murgui/AudioAmpli/Reference Documents/My_Ref FE - BOM (From v1.5 boards).xlsx

Sheet: BOM
My_Ref Fremen Edition BOM (v1.5 and up)
Position |  |  |  |  |  | Suggested Best Part |  | Mouser |  | Parts Connexion | Notes | Mouser Import Tool
Part |  | Value | Rating | Package | Q.ty | Manifacturer | Part | Order # | Notes | Order # |  | BOM (FE) | BOM (FE+Evo A Mod) | BOM w/o SMD (FE) | BOM w/o SMD (FE+Evo A Mod)
Amplifier
C1, C2 |  | 470uf | 50V | E7,5-16 | 2 | Nichicon | PW | 647-UPW1H471MHD |  |  |  | 647-UPW1H471MHD|2 | 647-UPW1H471MHD|2 | 647-UPW1H471MHD|2 | 647-UPW1H471MHD|2
C4 |  | 100nf | 250V | C10B5 | 1 | Wima | MKP4 | 505-MKP4.1/250/10P |  |  |  | 505-MKP4.1/250/10P|1 | 505-MKP4.1/250/10P|1 | 505-MKP4.1/250/10P|1 | 505-MKP4.1/250/10P|1
C7 |  | 10nf | 50V | C5B6.5 | 1 | Wima | FKP2 | 505-FKP20.01/100/2.5 |  |  |  | 505-FKP20.01/100/2.5|1 | 505-FKP20.01/100/2.5|1 | 505-FKP20.01/100/2.5|1 | 505-FKP20.01/100/2.5|1
C9 |  | 220uF | 50V | E7,5-16 | 1 | Elna | Cerafine (*) | 647-UKZ1H221MH | Nichicon KZ | BLKGATE-60166 | Blackgate STD and PK are best, if you can find them at decent price, The 4V PK from PCX are cheap and will work perfectly, buy them until they're available. Mouser alternate: 647-UFG1J221MHM | 647-UKZ1H221MH|1 | 647-UKZ1H221MH|1 | 647-UKZ1H221MH|1 | 647-UKZ1H221MH|1
C10 | (FE) | 33pF |  | C5B3.5 | 1 | CDE | CD10 | 598-CD10ED330JO3F |  |  |  | 598-CD10ED330JO3F|1 |  | 598-CD10ED330JO3F|1
 | (Evo Rev. A Mod) | Leave unpopulated
C12 |  | 220pf | 100V 2.5% | C5B4.5 | 1 | Amtrans | AMCH (**) | 505-FKP2220/100/2.5 | Wima FKP2 | AMTRANS-73778 |  | 505-FKP2220/100/2.5|1 | 505-FKP2220/100/2.5|1 | 505-FKP2220/100/2.5|1 | 505-FKP2220/100/2.5|1
C13 |  | 1uF | 250V | 24*38 | 1 | Mundorf | MCAP Supreme (***) | 598-940C6W1K-F | CDE 940C | MUNDORF-70326 |  | 598-940C6W1K-F|1 | 598-940C6W1K-F|1 | 598-940C6W1K-F|1 | 598-940C6W1K-F|1
C30 |  | 1nf | 100V | C5B4.5 | 1 | Amtrans | AMCH (**) | 505-FKP21000/100/2.5 | Wima FKP2 | AMTRANS-73784 |  | 505-FKP21000/100/2.5|1 | 505-FKP21000/100/2.5|1 | 505-FKP21000/100/2.5|1 | 505-FKP21000/100/2.5|1
C32 |  | 150pf | 100V 2.5% | C5B4.5 | 1 | Amtrans | AMCH (**) | 505-FKP2150/100/2.5 | Wima FKP2 | AMTRANS-73852 |  | 505-FKP2150/100/2.5|1 | 505-FKP2150/100/2.5|1 | 505-FKP2150/100/2.5|1 | 505-FKP2150/100/2.5|1
C34 |  | 27pf | 50V | C0805 | 1 | CDE | MC | 5982-08-100V27-F |  |  |  | 5982-08-100V27-F|1 | 5982-08-100V27-F|1
 | (FE Economy) |  |  |  | 1 | Vishay Vitramon | VJ Commercial (C0G) | 77-VJ0805A270JXBMC
D1, D2 |  | BAV99 |  | SOT23 | 2 | NXP | BAV-99 | 771-BAV99/8215 |  |  |  | 771-BAV99/8215|2 | 771-BAV99/8215|2
D3 |  | 27V | 1/2W | SOD80C | 1 | NXP | BZV55 | 771-BZV55-C27115 |  |  |  | 771-BZV55-C27115|1 | 771-BZV55-C27115|1
IC1 |  | LM318M |  | SO8 | 1 | NatSemi | LM318M | 926-LM318M/NOPB |  |  |  | 926-LM318M/NOPB|1 | 926-LM318M/NOPB|1
IC2 |  | LM3886TF |  | TO220-11 | 1 | NatSemi | LM3886TF | 926-LM3886TF/NOPB |  |  |  | 926-LM3886TF/NOPB|1 | 926-LM3886TF/NOPB|1 | 926-LM3886TF/NOPB|1 | 926-LM3886TF/NOPB|1
R2 |  | 10K | 1/4W 2% | R1206 | 1 | Vishay | CMA0204 | 594-CMA02040X1002GB3 |  |  |  | 594-CMA02040X1002GB3|1 | 594-CMA02040X1002GB3|1
R3 | (FE) | 0R47 | 5W | TO220 | 1 | Caddock | MP-930 | 684-MP930-0.5 |  |  |  | 684-MP930-0.5|1 |  | 684-MP930-0.5|1
 | (FE Economy) |  |  |  | 1 | Ohmite | TWW | 588-TWW5JR47E |  |  | No heaksing needed!
 | (Evo Rev. A Mod) | 0R33 | 5W | TO220 | 1 | Caddock | MP-930 | 684-MP930-0.33 |  |  |  |  | 684-MP930-0.33|1 |  | 684-MP930-0.33|1
R3 Heatsink |  |  |  | TO220 | 1 | Aavid Thermalloy |  | 532-577102B00 |  |  |  | 532-577102B00|1 | 532-577102B00|1 | 532-577102B00|1 | 532-577102B00|1
R5, R8 |  | 22K | 1/4W 0.1% | R1206 | 2 | Susumu | RG32 | 754-RG3216P-2202-BT5 |  |  |  | 754-RG3216P-2202-BT5|2 | 754-RG3216P-2202-BT5|2
R6, R9 |  | 47K | 1/4W 0.1% | R1206 | 2 | Susumu | RG32 | 754-RG3216P-4702-BT5 |  |  |  | 754-RG3216P-4702-BT5|2 | 754-RG3216P-4702-BT5|2
R7 |  | 12K | 1/4W 1% | B/R1206 | 1 | Susumu | RG32 (****) | 754-RG3216P-1202-BT5 |  | VISHAY-80834 |  | 754-RG3216P-1202-BT5|1 | 754-RG3216P-1202-BT5|1
R10 |  | 390R | 1/4W 1% | B/0207 | 1 | Vishay Dale | RN55 (****) | 71-RN55C3920B/R |  | VISHAY-74659 |  | 71-RN55C3920B/R|1 | 71-RN55C3920B/R|1 | 71-RN55C3920B/R|1 | 71-RN55C3920B/R|1
R11 |  | 1R | 1/4W 1% | 0207 | 1 | Vishay Dale | RN55 | 71-RN55D-F-1 |  |  |  | 71-RN55D-F-1|1 | 71-RN55D-F-1|1 | 71-RN55D-F-1|1 | 71-RN55D-F-1|1
R12 |  | 3K3 | 1/4W 1% | B/0207 | 1 | Vishay Dale | RN55 (****) | 71-RN55E3321B |  | VISHAY-73805 |  | 71-RN55E3321B|1 | 71-RN55E3321B|1 | 71-RN55E3321B|1 | 71-RN55E3321B|1
 | V1.5 Only |  |  |  | 1 | Susumu | RG32 | 754-RG3216P-3301DT5 |  | VISHAY-73805
R37 |  | 3K3 | 1/4W 1% | R1206 | 1 | Susumu | RG32 | 754-RG3216P-3301DT5 |  | VISHAY-73805 |  | 754-RG3216P-3301DT5|1 | 754-RG3216P-3301DT5|1
R13 |  | 100K | 1/4W 1% | B/0207 | 1 | Vishay Dale | RN55 (****) | 71-RN55E-B-100K |  | VISHAY-73811 |  | 71-RN55E-B-100K|1 | 71-RN55E-B-100K|1 | 71-RN55E-B-100K|1 | 71-RN55E-B-100K|1
R39 | (FE) | 470K | 1/4W 1% | R0805 | 1 | Susumu | RG20 | 754-RG2012P-474-BT5 |  |  |  | 754-RG2012P-474-BT5|1
 | (Evo Rev. A Mod) | Leave unpopulated
R43 |  | 22K | 1/4W 1% | R0805 | 1 | Susumu | RG20 | 754-RG2012P-223-B-T5 |  |  | Alt. 754-RS2012P-223-DT53 | 754-RG2012P-223-B-T5 |1 | 754-RG2012P-223-B-T5 |1
Power Supply
C101, C201 |  | 10,000uf | 50V | EB35D | 2 | Mundorf | M-Lythic AG | 594-MAL225658103E3 | 256 PMG-SI | MUNDORF-74876 | Alternate: 647-LKG1H103MESCBK | 594-MAL225658103E3|2 | 594-MAL225658103E3|2 | 594-MAL225658103E3|2 | 594-MAL225658103E3|2
C103, C203 | (Optional) | 100nF | 100V C0G | C1206 | 2 | TDK | C Series | 810-C3216C0G2A104J6C |  |  | Not needed
D105, D205 |  | 14V | 1/2W | DO35 | 2 | Fairchild | 1N5244B | 512-1N5244B |  |  |  | 512-1N5244B|2 | 512-1N5244B|2 | 512-1N5244B|2 | 512-1N5244B|2
D101-D104, D201-D204 |  | MUR820 |  | TO220 | 8 | OnSemi | MUR820G | 863-MUR820G |  |  |  | 863-MUR820G|8 | 863-MUR820G|8 | 863-MUR820G|8 | 863-MUR820G|8
IC101, IC201 |  | LM317 |  | TO220 | 2 | OnSemi | LM317TG | 863-LM317TG |  |  |  | 863-LM317TG|2 | 863-LM317TG|2 | 863-LM317TG|2 | 863-LM317TG|2
IC101, IC201 Heatsink |  |  |  | TO220 | 2 | Aavid Thermalloy | 577102B00000G | 532-577102B00 |  |  | Alternate: 532-577002B00 | 532-577102B00|2 | 532-577102B00|2 | 532-577102B00|2 | 532-577102B00|2
TO 220 Mounting kit |  |  |  |  | 2 | Aavid Thermalloy | 4880MG | 532-4880M |  |  |  | 532-4880M|2 | 532-4880M|2 | 532-4880M|2 | 532-4880M|2
R101, R201 |  | 50R | 1/2W 1% | B/0207 | 2 | Vishay Dale | RN55 | 71-RN55C-B-50 |  |  |  | 71-RN55C-B-50|2 | 71-RN55C-B-50|2 | 71-RN55C-B-50|2 | 71-RN55C-B-50|2
R104, R204 |  | 200R | 1/2W 1% | B/0207 | 2 | Vishay Dale | RN55 | 71-RN55C-B-200/R |  |  |  | 71-RN55C-B-200/R|2 | 71-RN55C-B-200/R|2 | 71-RN55C-B-200/R|2 | 71-RN55C-B-200/R|2
T101 |  | BD139-16 | 1W | TO126 | 1 | Fairchild | BD139-16 | 512-BD13916S |  |  |  | 512-BD13916S|1 | 512-BD13916S|1 | 512-BD13916S|1 | 512-BD13916S|1
T201 |  | BD140-16 | 1W | TO126 | 1 | Fairchild | BD140-16 | 512-BD14016S |  |  |  | 512-BD14016S|1 | 512-BD14016S|1 | 512-BD14016S|1 | 512-BD14016S|1
DC & Speaker Protection
C14 |  | 220uf | 50V | E5-10.5 | 1 | Panasonic | FM | 667-EEU-FM1H221 |  |  |  | 667-EEU-FM1H221|1 | 667-EEU-FM1H221|1 | 667-EEU-FM1H221|1 | 667-EEU-FM1H221|1
C15 |  | 22uf | 25V | E2,5-5 | 1 | Nichicon | FG | 647-UFG1E220MDM |  |  |  | 647-UFG1E220MDM|1 | 647-UFG1E220MDM|1 | 647-UFG1E220MDM|1 | 647-UFG1E220MDM|1
C16 |  | 100uf | 25V | E3.5-8 | 1 | Nichicon | FG | 647-UFG1E101MPM |  |  |  | 647-UFG1E101MPM|1 | 647-UFG1E101MPM|1 | 647-UFG1E101MPM|1 | 647-UFG1E101MPM|1
D4 |  | 1N4001 |  | D-7.5 | 1 | Any | 1N4001 | 625-1N4001-E3/54 |  |  |  | 625-1N4001-E3/54|1 | 625-1N4001-E3/54|1 | 625-1N4001-E3/54|1 | 625-1N4001-E3/54|1
DR1, DR2 |  | SBYV27 | 100V | D-10 | 2 | Vishay | SBYV27-100 | 625-SBYV27-100-E3 |  |  |  | 625-SBYV27-100-E3|2 | 625-SBYV27-100-E3|2 | 625-SBYV27-100-E3|2 | 625-SBYV27-100-E3|2
LED |  | Red |  | 3mm | 1 | Any |  | 78-TLHR4900 |  |  |  | 78-TLHR4900|1 | 78-TLHR4900|1 | 78-TLHR4900|1 | 78-TLHR4900|1
R14 |  | 470R | 2W | 0409 | 1 | Any |  | MOS1CT52R471J | KOA MF |  |  | MOS1CT52R471J|1 | MOS1CT52R471J|1 | MOS1CT52R471J|1 | MOS1CT52R471J|1
R15, R16 |  | 75K | 1/4W | 0207 | 2 | Any |  | 660-MF1/4CC7502F | KOA MF |  |  | 660-MF1/4CC7502F|2 | 660-MF1/4CC7502F|2 | 660-MF1/4CC7502F|2 | 660-MF1/4CC7502F|2
R19 |  | 10K | 1/4W | 0207 | 1 | Any |  | 660-MF1/4CC1002F | KOA MF |  |  | 660-MF1/4CC1002F|1 | 660-MF1/4CC1002F|1 | 660-MF1/4CC1002F|1 | 660-MF1/4CC1002F|1
R20 |  | 47K | 1/4W | 0207 | 1 | Any |  | 660-MF1/4CC4702F | KOA MF |  |  | 660-MF1/4CC4702F|1 | 660-MF1/4CC4702F|1 | 660-MF1/4CC4702F|1 | 660-MF1/4CC4702F|1
R21 |  | 220K | 1/4W | 0207 | 1 | Any |  | 660-MF1/4CC2213F | KOA MF |  |  | 660-MF1/4CC2213F|1 | 660-MF1/4CC2213F|1 | 660-MF1/4CC2213F|1 | 660-MF1/4CC2213F|1
R22 |  | 8K2 | 1/4W | 0207 | 1 | Any |  | 660-MF1/4DCT52R8201F | KOA MF |  |  | 660-MF1/4DCT52R8201F|1 | 660-MF1/4DCT52R8201F|1 | 660-MF1/4DCT52R8201F|1 | 660-MF1/4DCT52R8201F|1
R23 |  | 6K8 | 1W | 0207 | 1 | Any |  | MF1/2DC6811F | KOA MF |  |  | MF1/2DC6811F|1 | MF1/2DC6811F|1 | MF1/2DC6811F|1 | MF1/2DC6811F|1
K1 |  | G5LE | DC24V |  | 1 | Omron | G5LE-14-DC24 | 653-G5LE-14-DC24 |  |  | Alternate: 653-G5LE-1-DC24 | 653-G5LE-14-DC24|1 | 653-G5LE-14-DC24|1 | 653-G5LE-14-DC24|1 | 653-G5LE-14-DC24|1
Q1 |  | BC639 |  | TO-92 | 1 | Any |  | 512-BC63916D74Z | Fairchild |  |  | 512-BC63916D74Z|1 | 512-BC63916D74Z|1 | 512-BC63916D74Z|1 | 512-BC63916D74Z|1
Q2, Q3 |  | BC546A |  | TO-92 | 2 | Any |  | 512-BC546CTA | Fairchild |  |  | 512-BC546CTA|2 | 512-BC546CTA|2 | 512-BC546CTA|2 | 512-BC546CTA|2
Connectors & Hardware
AC1, AC2, NAC1, NAC2,OUT, OUT_GND, PWR_GND | PCB Faston |  |  |  | 7 | Keystone / Tyco | 1287 | 534-1287 |  |  |  | 534-1287|7 | 534-1287|7 | 534-1287|7 | 534-1287|7
AC1, AC2, NAC1, NAC2,OUT, OUT_GND, PWR_GND | Faston | Brass |  |  | 7 | TE |  | 571-612271 |  |  |  | 571-612271|7 | 571-612271|7 | 571-612271|7 | 571-612271|7
IN (Pin steap header) |  | Gold plated |  |  | 1 | Molex | 22-11-2022 | 538-22-11-2022 |  |  |  | 538-22-11-2022|1 | 538-22-11-2022|1 | 538-22-11-2022|1 | 538-22-11-2022|1
EXT_LED (Pin steap header) |  | Tinned |  |  | 1 | Molex | 22-23-2021 | 538-22-23-2021 |  |  |  | 538-22-23-2021|1 | 538-22-23-2021|1 | 538-22-23-2021|1 | 538-22-23-2021|1
Molex crimp pin |  | Gold plated |  |  | 6 | Molex | 08-65-0816 | 538-08-65-0816 |  |  |  | 538-08-65-0816|6 | 538-08-65-0816|6 | 538-08-65-0816|6 | 538-08-65-0816|6
Molex crimp housing |  |  |  |  | 2 | Molex | 10-11-2023 | 538-10-11-2023 |  |  |  | 538-10-11-2023|2 | 538-10-11-2023|2 | 538-10-11-2023|2 | 538-10-11-2023|2
Spacer |  | M3 |  |  | 4 | Harwin | R30-1001002 | 855-R30-1001002 |  |  |  | 855-R30-1001002|4 | 855-R30-1001002|4 | 855-R30-1001002|4 | 855-R30-1001002|4
Phillips Screw |  | M3 |  |  | 8 | APM HEXSEAL | RM3X8MM | 608-RM3X8MM |  |  |  | 608-RM3X8MM|8 | 608-RM3X8MM|8 | 608-RM3X8MM|8 | 608-RM3X8MM|8
 |  |  |  |  |  |  |  |  |  |  |  | Circa 71€ (VAT Excluded) | Circa 68€ (VAT Excluded) | Circa 62€ (VAT Excluded) | Circa 61€ (VAT Excluded)
This BOM is for one (1) PCB. You must order two (2) to populate a stereo kit
Parts in blue are from My_Evo Rev. A mod, that mod is applicable also to the My_Ref FE and is a further improvement in measured and perceived performance.
Parts in purple are supplied with the SMD Option.
Parts matching it's not necessary, though the amp will benefit from matched HFE for BD139/BD140 and 1N5244B. All resistors are 0.1% so no matching is needed at all.
(*) Cerafines (50V minumum) have an open and direct sound, similar to Black Gate PK, while KZs are also similar to Black Gate in timbre but more laid back. Silmic II Black/Gold will sound very good too but different, very musical and inviting but lacks a bit of detail and sparkle, soft bass. You can swap among them to tailor amp sound to your taste.
(**) Amtrans are more neutral and refined than FKP2
(***) Supremes sounds really good, more detailed and revealing but never harsh
(****) Vishay Z-Foils are for the ultimate cost no-object My_Ref FE, Z-Foils are richer, more neutral, refined and detailed. RN55 are more laid back with less sparkle. Best positions for them are probably R12 (first) and R10 (second)
For US partecipants, Sonicraft has way better prices than PCX for Mundorf Capacitors, particularly for AGs.

Sheet: Others
Mouser order # | Description
910-SMD1NL | Chip Quik SMD Kit (Tacky flux, desoldering alloy)
910-SMD4.5NL | Chip Quik desoldering alloy only
910-SMD291 | Chip Quik tacky flux alone
506-510-AG90D | SIL sockets for easy components swap
565-3770-0 | Ponoma Gold plated tellurium copper binfindg posts (Black)
565-3770-2 | Ponoma Gold plated tellurium copper binfindg posts (Red)
568-NYS367-9 | white gold plated brass phono RCA
568-NYS367-2 | red gold plated brass phono RCA
