murgui/AudioAmpli/Design/Components analysis/COmponent list.ods

se usaran componentes smd 1206 whenever possible, caps 0805
designator | pn | desc | stock | price for 1 unit | units | total price € | comment | footprint | creado
c13 | R82DC4100AA60K | input stage cap 1uf | 577 | 0.4 | 1 |  |  | film cap 1uf
c13 | SMDTC04100VA00KR00 (https://www.mouser.es/ProductDetail/WIMA/SMDTC04100VA00KR00?qs=KSac9zHBIo3kHgvXfYcpbw%3D%3D) | input stage cap 1uf | 709 | 1.63 | 1 | 1.63 |  | film cap 1uf | yes
r12 | RK73B2BTTDD332J | input stage R3k3 | 2000 | 0.1 | 1 | 0.1 |  | R1206 | yes
c12 | GRM219R72A221KA01D |  | 1300 | 0.2 | 1 | 0.2 |  | C0805 | yes
r13 | RK73B2BTTDD104J | input stage 100k | 6900 | 0.1 | 1 | 0.1 |  | R1206 | yes
r10 | RK73B2BTTDD391J (https://www.mouser.es/ProductDetail/KOA-Speer/RK73B2BTTDD391J?qs=xh6XbFK48Rg4XiFUBZkS%2Fw%3D%3D) | input stage R390 | 2300 | 0.1 | 1 | 0.1 |  | R1206 | yes
R7 | RK73H2BTTD1202F (https://www.mouser.es/ProductDetail/KOA-Speer/RK73H2BTTD1202F?qs=01cQMEOqxGS0rsHHZoJuWA%3D%3D) | 12k | 2300 | 0.1 | 1 | 0.1 |  | R1206 | yes
c32 | GRM2165C2A151JA01D (https://www.mouser.es/ProductDetail/Murata-Electronics/GRM2165C2A151JA01D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) | 150pf | 4300 | 0.18 | 1 | 0.18 |  | C0805 | yes
c10 | GRM21A5C2D220JW01D | 22pf |  | 0.28 | 1 | 0.28 |  | C0805 | yes
r43, R5, R8 | RK73B2BTTDD223J (https://www.mouser.es/ProductDetail/KOA-Speer/RK73B2BTTDD223J?qs=xh6XbFK48RgETOIQj0KCRg%3D%3D) | 22k | 2800 | 0.1 | 3 | 0.3 |  | R1206 | yes
r39 | SG732BTTD474K (https://www.mouser.es/ProductDetail/KOA-Speer/SG732BTTD474K?qs=0U9fANxrh6mO3w0KV2D%252Bpg%3D%3D) | 470k | 3200 | 0.3 | 1 | 0.3 |  | R1206 | yes
c34 | GRM21A5C2D100JW01D | 10p | 4500 | 0.28 | 1 | 0.28 |  | C0805 | yes
c7 | GRM219R72A103KA01D (https://www.mouser.es/ProductDetail/Murata-Electronics/GRM219R72A103KA01D) | 10n | 7600 | 0.15 | 1 | 0.15 |  | C0805 | yes
d1, d2 | BAV99W,LF (https://www.mouser.es/ProductDetail/Toshiba/BAV99WLF?qs=BZBei1rCqCDkxbBm007JFw%3D%3D) | diodo | 8300 | 0.2 | 2 | 0.4 |  | custom | yes
d3 | BZV55-C27,115 (https://www.mouser.es/ProductDetail/Nexperia/BZV55-C27115?qs=me8TqzrmIYX0ElDTobiQrA%3D%3D) | diodo | 21k | 0.19 | 1 | 0.19 |  | custom | yes
U1 | LM318M/NOPB (https://www.mouser.es/ProductDetail/Texas-Instruments/LM318M-NOPB?qs=X1J7HmVL2ZE1vlHF%2FW52Jg%3D%3D) | opamp | 1900 | 1.4 | 1 | 1.4 |  | custom | yes
R6, R9 | RK73H2BTTD4702F (https://www.mouser.es/ProductDetail/KOA-Speer/RK73H2BTTD4702F?qs=Y80TxmMMbuNbqFqxrJ%252BWhA%3D%3D) | 47k | 250 | 0.1 | 2 | 0.2 |  | R1206 | yes
R37 | RK73B2BTTDD332J (https://www.mouser.es/ProductDetail/KOA-Speer/RK73B2BTTDD332J?qs=xh6XbFK48RhBzINM3NENAg%3D%3D) | 3k3 | 2300 | 0.1 | 1 | 0.1 |  | R1206 | yes
c30 | GRM219R72A102KA01D (https://www.mouser.es/ProductDetail/Murata-Electronics/GRM219R72A102KA01D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) | 1nf | 27k | 0.18 | 1 | 0.18 |  | C0805 | yes
c1. c2, c9 | ESH227M063AH4AA (https://www.mouser.es/ProductDetail/KEMET/ESH227M063AH4AA) | 220uF | 2000 | 0.55 | 3 | 1.65 |  | custom | yes
R2 | RK73B2BTTD103G (https://www.mouser.es/ProductDetail/KOA-Speer/RK73B2BTTD103G?qs=hfa5cSuexEzqNdLcx7fQzw%3D%3D) | 10k | 1900 | 0.1 | 1 | 0.1 |  | R1206 | yes
R3 | RWS7 R47 J T&R | 470mOhm 7W | 192 | 2.12 | 1 | 2.12 |  | custom | yes
U2 | LM3886T | ampli |  | 10.35 | 1 | 10.35 |  | custom | yes
C4 | GRM21BR72A104KAC4L (https://www.mouser.es/ProductDetail/Murata-Electronics/GRM21BR72A104KAC4L?qs=QdePRyQsNGYp7U6peP3wvA%3D%3D) | 100nF | 30k | 0.26 | 1 | 0.26 |  | C0805 | yes
 | ACS722LLCTR-05AB-T (https://www.mouser.es/ProductDetail/Allegro-MicroSystems/ACS722LLCTR-05AB-T?qs=pUKx8fyJudCx1UVzvqolkw%3D%3D) | current sense to detect OVC | 12k | 4 | 1 | 4 | NOK as current at 4Ohm 56W is 4.93Apk
 |  |  |  |  | total | 24.67
