murgui/AudioAmpli/AltiumProject/Components Creation/ComponentDownload/LM3886/TF11B.step

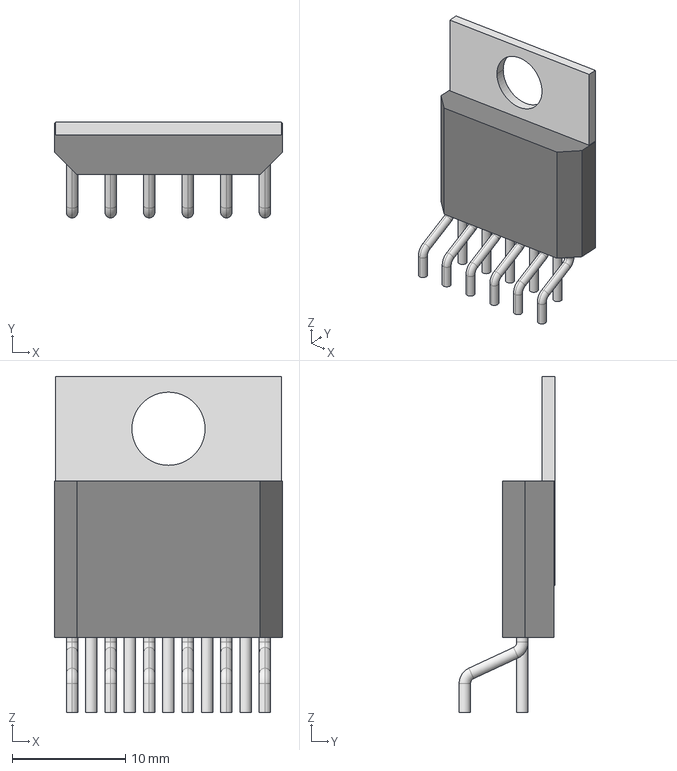
[picture p3: CAD file, 2022-03-06]
AltiumProject/Components Creation/ComponentDownload/LM3886/TF11B.step
20.1 x 8.46 x 29.6 mm
