murgui/AudioAmpli/AltiumProject/Components Creation/ESH227M063AH4AA.step

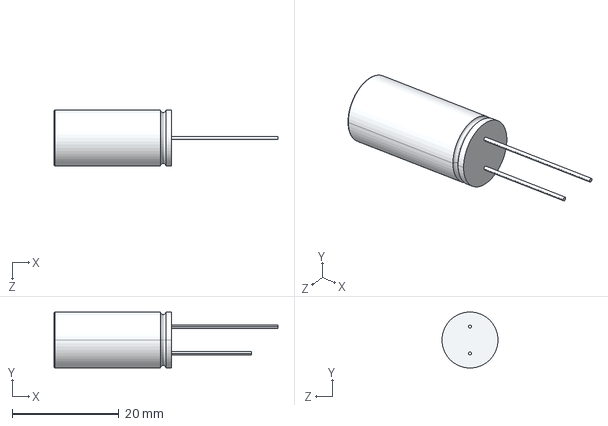
[picture p4: CAD file, 2022-07-03]
AltiumProject/Components Creation/ESH227M063AH4AA.step
42.0 x 10.5 x 10.5 mm
