murgui/AudioAmpli/AltiumProject/Components Creation/UltraLibrarian/AltiumDesigner/2022-06-25_15-40-44/RES_RK73B_1J_KOA.step

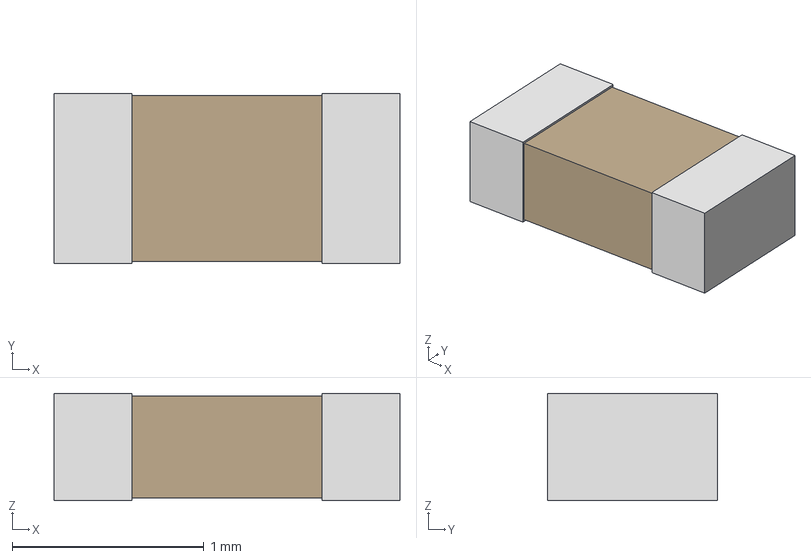
[picture p5: CAD file, 2022-07-02]
AltiumProject/Components Creation/UltraLibrarian/AltiumDesigner/2022-06-25_15-40-44/RES_RK73B_1J_KOA.step
1.80 x 0.888 x 0.559 mm
