murgui/AudioAmpli/AltiumProject/Components Creation/ComponentDownload/c-282836-3-j-3d.stp

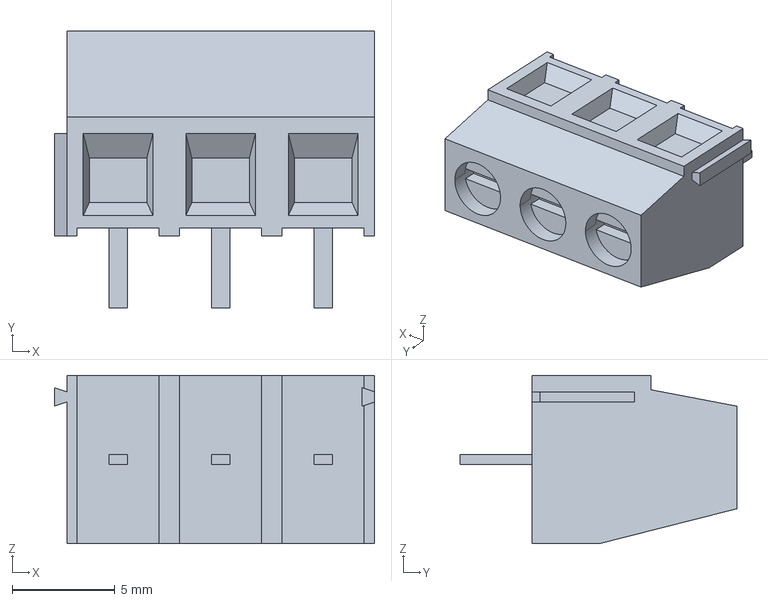
[picture p6: CAD file, 2022-07-19]
AltiumProject/Components Creation/ComponentDownload/c-282836-3-j-3d.stp
15.6 x 13.5 x 8.20 mm
