murgui/AudioAmpli/AltiumProject/Components Creation/ComponentDownload/c-282836-4-j-3d.stp

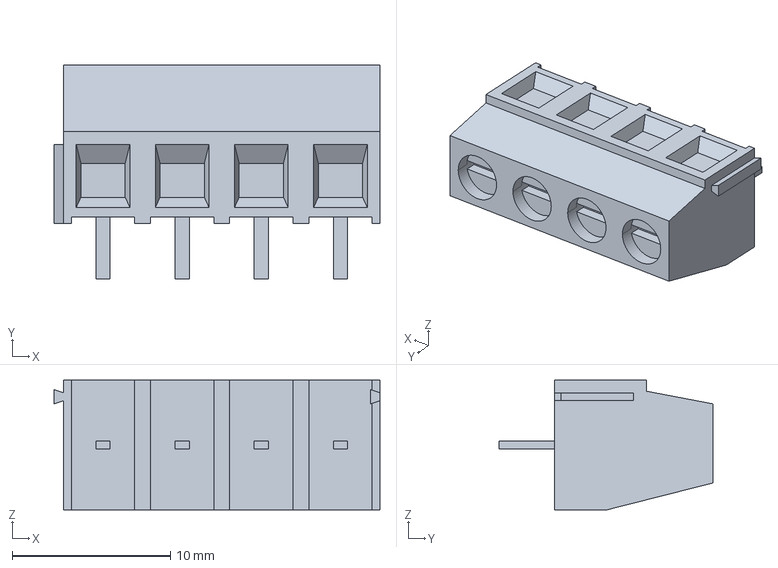
[picture p7: CAD file, 2022-07-19]
AltiumProject/Components Creation/ComponentDownload/c-282836-4-j-3d.stp
20.6 x 13.5 x 8.20 mm
