murgui/AudioAmpli/AltiumProject/Components Creation/ComponentDownload/39303032.stp

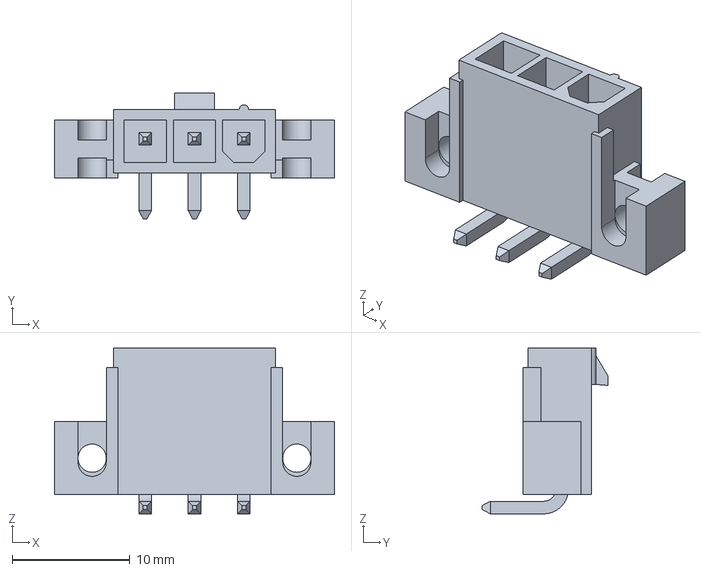
[picture p8: CAD file, 2022-07-27]
AltiumProject/Components Creation/ComponentDownload/39303032.stp
23.8 x 10.7 x 14.1 mm
