murgui/AudioAmpli/AltiumProject/Components Creation/ComponentDownload/39303041.stp

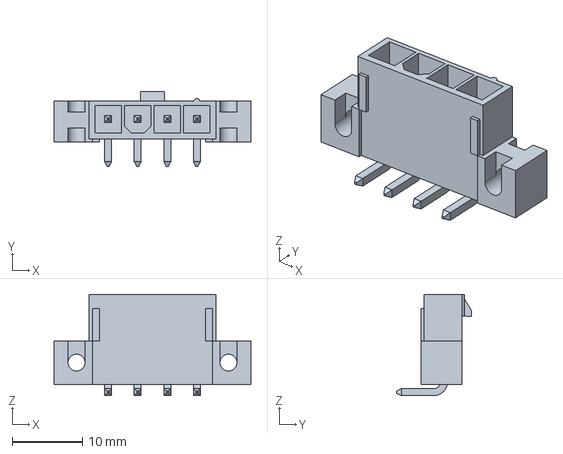
[picture p9: CAD file, 2022-07-27]
AltiumProject/Components Creation/ComponentDownload/39303041.stp
28.0 x 10.7 x 14.4 mm
