murgui/AudioAmpli/Reference Documents/My_Ref_FE - Schematic 1.5.pdf

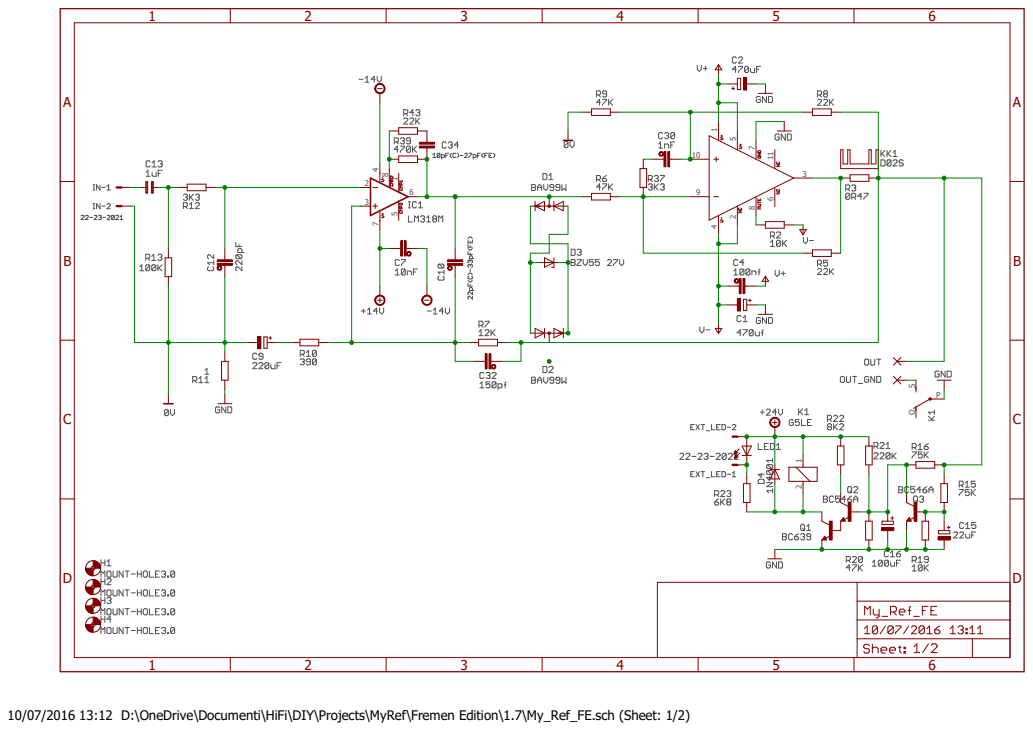
[picture p10: page 1]
10/07/2016 13:12 D:\OneDrive\Documenti\HiFi\DIY\Projects\MyRef\Fremen Edition\1.7\My_Ref_FE.sch (Sheet: 1/2)
