murgui/AudioAmpli/Design/OPAMP supply/LowVoltageSupplyZenerApproach.asc

C1: cap; 100µ
D1: zener; SMAZ15
OPAMPs: res; 1500
R1: res; 2.2k
V1: voltage; 37
Named nets: 0
.tran 0 500m 1m uic
.inc SMAZ15.spice.txt
