murgui/AudioAmpli/(list of files, drawings)

Other design files:
AltiumProject/Architecture.SchDoc
AltiumProject/AudioAmp.PcbLib
AltiumProject/AudioAmplifier.PrjPcb
AltiumProject/AudioAmplifier.SchDoc
AltiumProject/AudioAmpPCB.PcbDoc
AltiumProject/AudioAmpSchematic.SchDoc
AltiumProject/AudioAmpSchLib.SchLib
AltiumProject/Component Libraries K/Component Libraries/Capacitors.PcbLib
AltiumProject/Component Libraries K/Component Libraries/Capacitors.SchLib
AltiumProject/Component Libraries K/Component Libraries/Connectors.PcbLib
AltiumProject/Component Libraries K/Component Libraries/Connectors.SchLib
AltiumProject/Component Libraries K/Component Libraries/DiscreteSemiconductors.PcbLib
AltiumProject/Component Libraries K/Component Libraries/DiscreteSemiconductors.SchLib
AltiumProject/Component Libraries K/Component Libraries/ICs.PcbLib
AltiumProject/Component Libraries K/Component Libraries/ICs.SchLib
AltiumProject/Component Libraries K/Component Libraries/Inductors.PcbLib
AltiumProject/Component Libraries K/Component Libraries/Inductors.SchLib
AltiumProject/Component Libraries K/Component Libraries/Other.PcbLib
AltiumProject/Component Libraries K/Component Libraries/Other.SchLib
AltiumProject/Component Libraries K/Component Libraries/Resistors.PcbLib
AltiumProject/Component Libraries K/Component Libraries/Resistors.SchLib
AltiumProject/Components Creation/ComponentDownload/LM3886/LM3886TF&slash_NOPB.PcbLib
AltiumProject/Components Creation/ComponentDownload/LM3886/LM3886TF&slash_NOPB.SchLib
AltiumProject/Components Creation/UltraLibrarian/AltiumDesigner/2022-06-25_15-40-44/RK73B1JTTD100J.PcbLib
AltiumProject/Components Creation/UltraLibrarian/AltiumDesigner/2022-06-25_15-40-44/RK73B1JTTD100J.SchLib
AltiumProject/Components Creation/UltraLibrarian/AltiumDesigner/2022-07-15_20-19-17/282836-3.PcbLib
AltiumProject/Components Creation/UltraLibrarian/AltiumDesigner/2022-07-15_20-19-17/282836-3.SchLib
AltiumProject/Components Creation/UltraLibrarian/AltiumDesigner/2022-07-19_18-04-54/282836-4.PcbLib
AltiumProject/Components Creation/UltraLibrarian/AltiumDesigner/2022-07-19_18-04-54/282836-4.SchLib
AltiumProject/Components Creation/UltraLibrarian/AltiumDesigner/2022-07-27_17-10-26/39303032.PcbLib
AltiumProject/Components Creation/UltraLibrarian/AltiumDesigner/2022-07-27_17-10-26/39303032.SchLib
AltiumProject/Components Creation/UltraLibrarian/AltiumDesigner/2022-07-27_17-19-56/39303041.PcbLib
AltiumProject/Components Creation/UltraLibrarian/AltiumDesigner/2022-07-27_17-19-56/39303041.SchLib
AltiumProject/OPAMPSupply.SchDoc
