murgui/AudioAmpli/(commit log)

2022-03-06 Added reference documents
    [My_Ref FE - BOM (From v1.5 boards).xlsx]
2022-03-06 Added Altium project
    [Architecture.SchDoc, AudioAmp.PcbLib, AudioAmpPCB.PcbDoc, AudioAmpSchLib.SchLib, AudioAmpSchematic.SchDoc, AudioAmplifier.PrjPcb, LM3886TF&slash_NOPB.PcbLib, LM3886TF&slash_NOPB.SchLib]
2022-06-21 Started working in SCH lib and ocmpleted BOM proposed PN
    [AudioAmp.PcbLib, AudioAmpSchLib.SchLib, AudioAmplifier.PrjPcb, AudioAmplifier.SchDoc, COmponent list.ods]
2022-07-02 Some components created
    [AudioAmp.PcbLib, AudioAmpSchLib.SchLib, COmponent list.ods, Capacitors.PcbLib, Capacitors.SchLib, Connectors.PcbLib, Connectors.SchLib, DiscreteSemiconductors.PcbLib]
2022-07-03 Sch of single stage amplifier ccompleted
    [AudioAmp.PcbLib, AudioAmpPCB.PcbDoc, AudioAmpSchLib.SchLib, AudioAmpSchematic.SchDoc, AudioAmplifier.PrjPcb, AudioAmplifier.SchDoc, COmponent list.ods, ESH227M063AH4AA.step]
2022-07-07 flipped C18 to match polarities
    [AudioAmplifier.SchDoc]
2022-07-08 Added fiducials, mounting holes, TPs
    [Architecture.SchDoc, AudioAmp.PcbLib, AudioAmpSchLib.SchLib, AudioAmplifier.SchDoc]
2022-07-08 Added PNs of connectors to be used
    [Architecture.SchDoc]
2022-07-15 Added connector to lib and placed in arch sheet
    [282836-3.PcbLib, 282836-3.SchLib, Architecture.SchDoc, AudioAmp.PcbLib, AudioAmpSchLib.SchLib]
2022-07-19 WIP connectors creation
    [282836-4.PcbLib, 282836-4.SchLib, Architecture.SchDoc, AudioAmp.PcbLib, AudioAmpSchLib.SchLib, c-282836-3-j-3d.stp, c-282836-4-j-3d.stp]
2022-07-27 Added molex connectors
    [39303032.PcbLib, 39303032.SchLib, 39303032.stp, 39303041.PcbLib, 39303041.SchLib, 39303041.stp, Architecture.SchDoc, AudioAmp.PcbLib]
2022-07-30 Low voltage supply started, arch. ongoing
    [Architecture.SchDoc, AudioAmp.PcbLib, AudioAmpSchLib.SchLib, AudioAmplifier.PrjPcb, AudioAmplifier.SchDoc, OPAMPSupply.SchDoc]
2022-07-30 Completed low voltage supply
    [AudioAmp.PcbLib, AudioAmpSchLib.SchLib, OPAMPSupply.SchDoc]
2022-07-30 Preplacement started
    [Architecture.SchDoc, AudioAmpPCB.PcbDoc, AudioAmplifier.PrjPcb, AudioAmplifier.SchDoc, OPAMPSupply.SchDoc]
