murgui/AudioAmpli/(notices)

Notices in the files:
AltiumProject/Components Creation/ComponentDownload/39303041.stp:
author */ ('License CC BY-ND 4.0'),
